derrildsouza/Advanced-IoT-Home-Automation-System/docs/images/board_cliparts_showcase.jpg

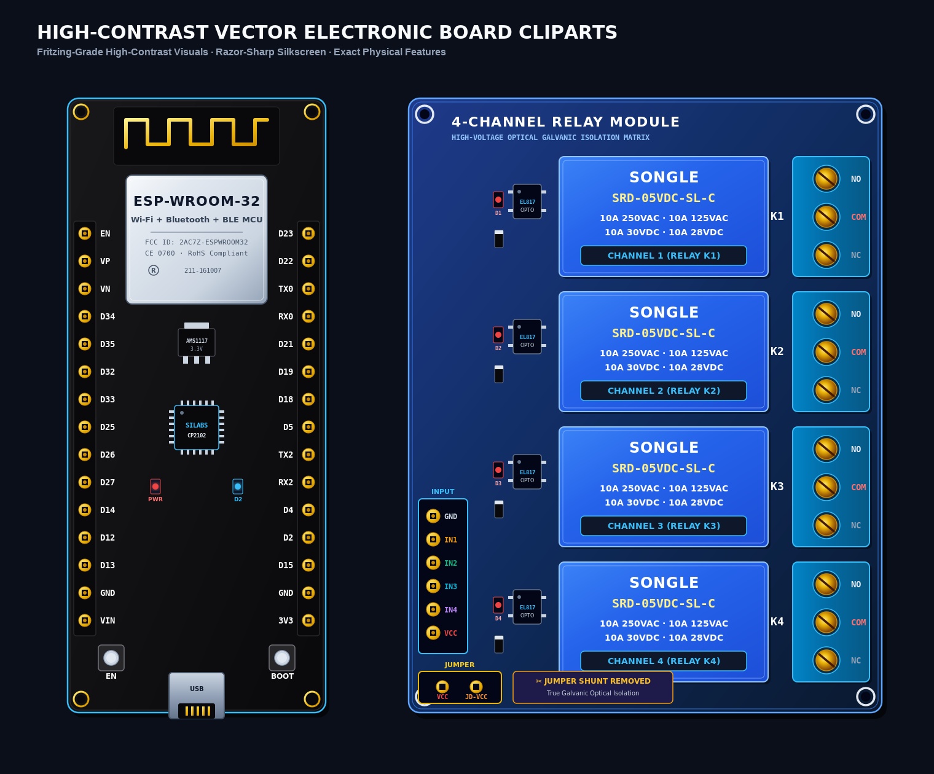
docs/images/board_cliparts_showcase.jpg
