derrildsouza/Advanced-IoT-Home-Automation-System/docs/images/esp32_board_clipart.png

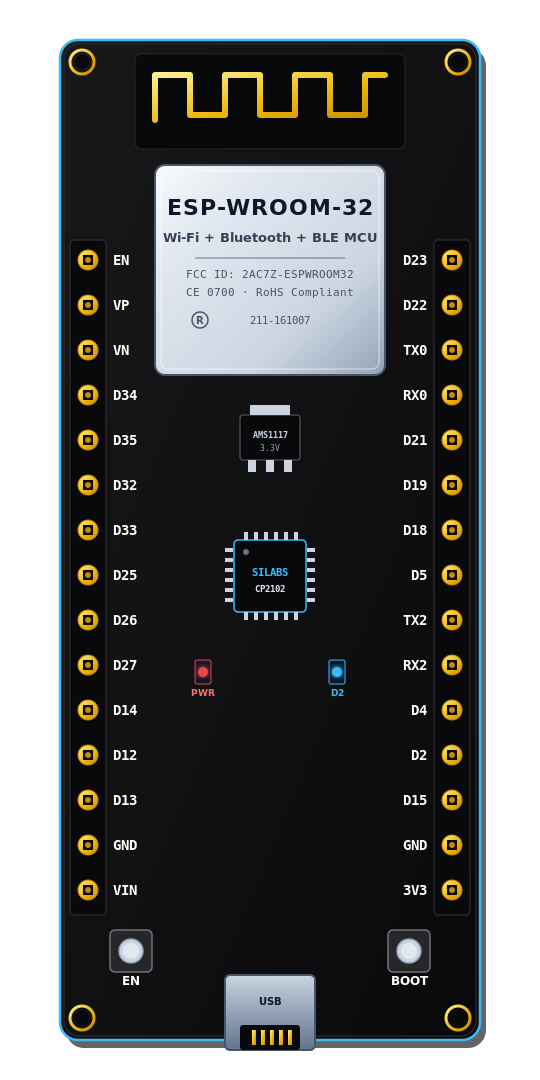
docs/images/esp32_board_clipart.png
