derrildsouza/Advanced-IoT-Home-Automation-System/docs/images/esp32_board_photo.png

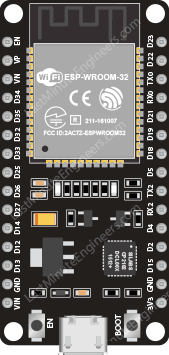
docs/images/esp32_board_photo.png
