derrildsouza/Advanced-IoT-Home-Automation-System/docs/images/hlk_ams1117_schematic.jpg

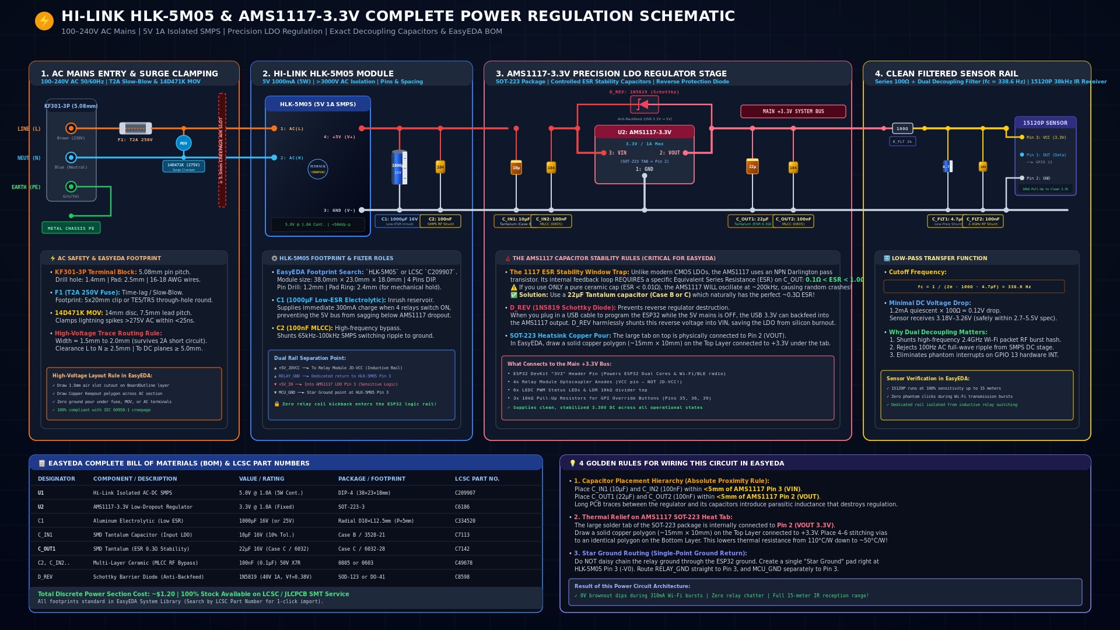
docs/images/hlk_ams1117_schematic.jpg
