derrildsouza/Advanced-IoT-Home-Automation-System/docs/images/minimal_power_schematic.jpg

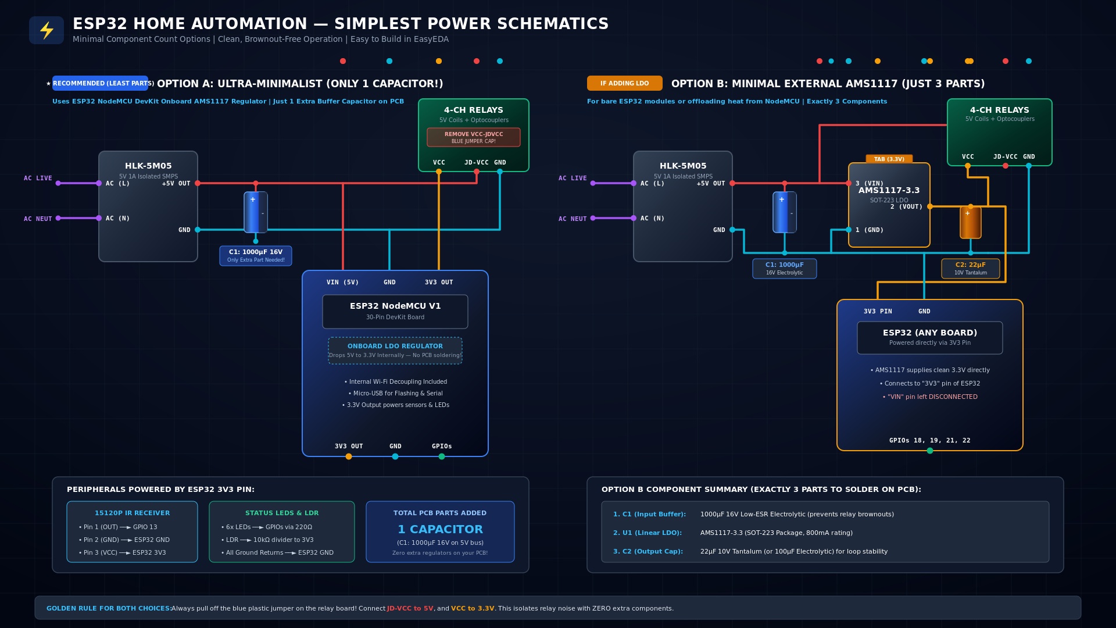
docs/images/minimal_power_schematic.jpg
