derrildsouza/Advanced-IoT-Home-Automation-System/docs/images/relay_module_clipart.png

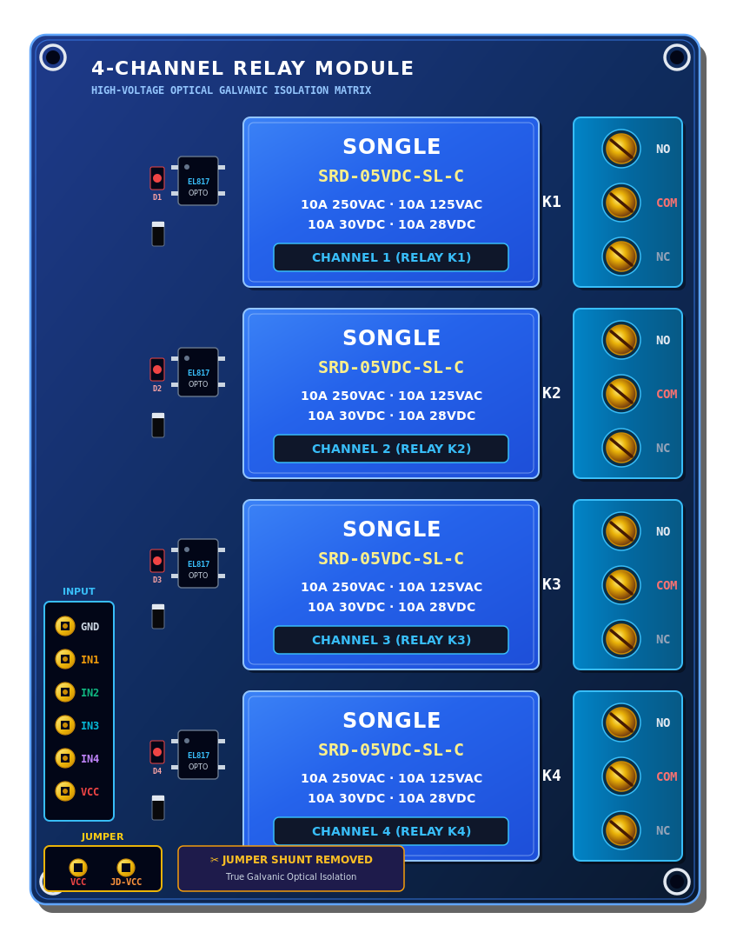
docs/images/relay_module_clipart.png
