derrildsouza/Advanced-IoT-Home-Automation-System/docs/images/relay_module_photo.png

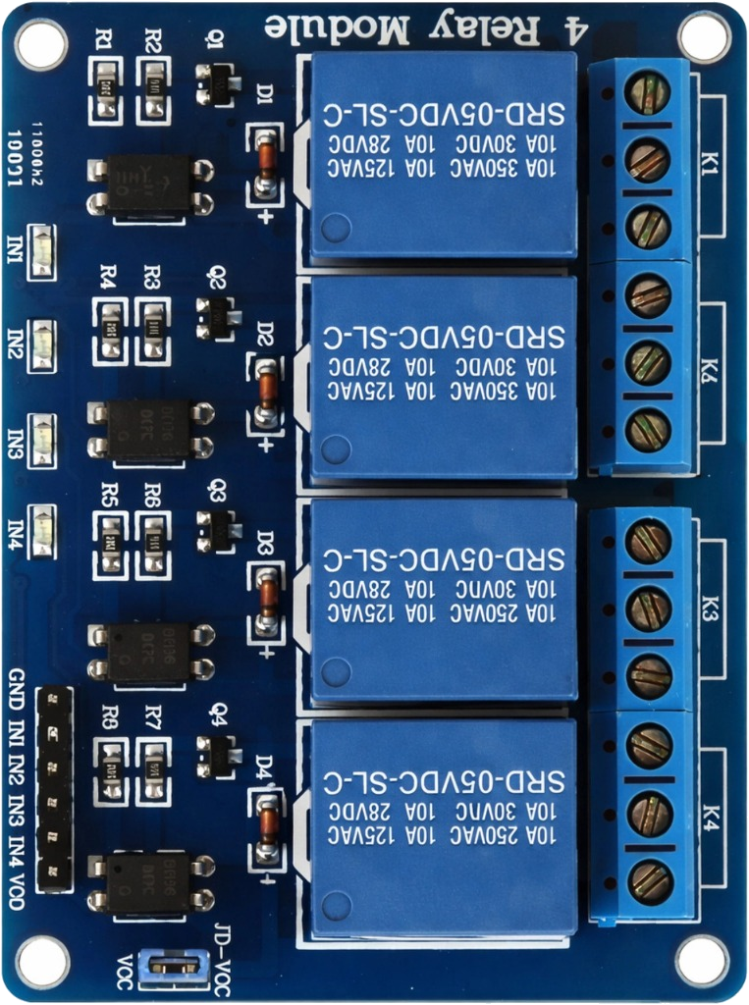
docs/images/relay_module_photo.png
