derrildsouza/Advanced-IoT-Home-Automation-System/docs/images/sensors_and_io_schematic.jpg

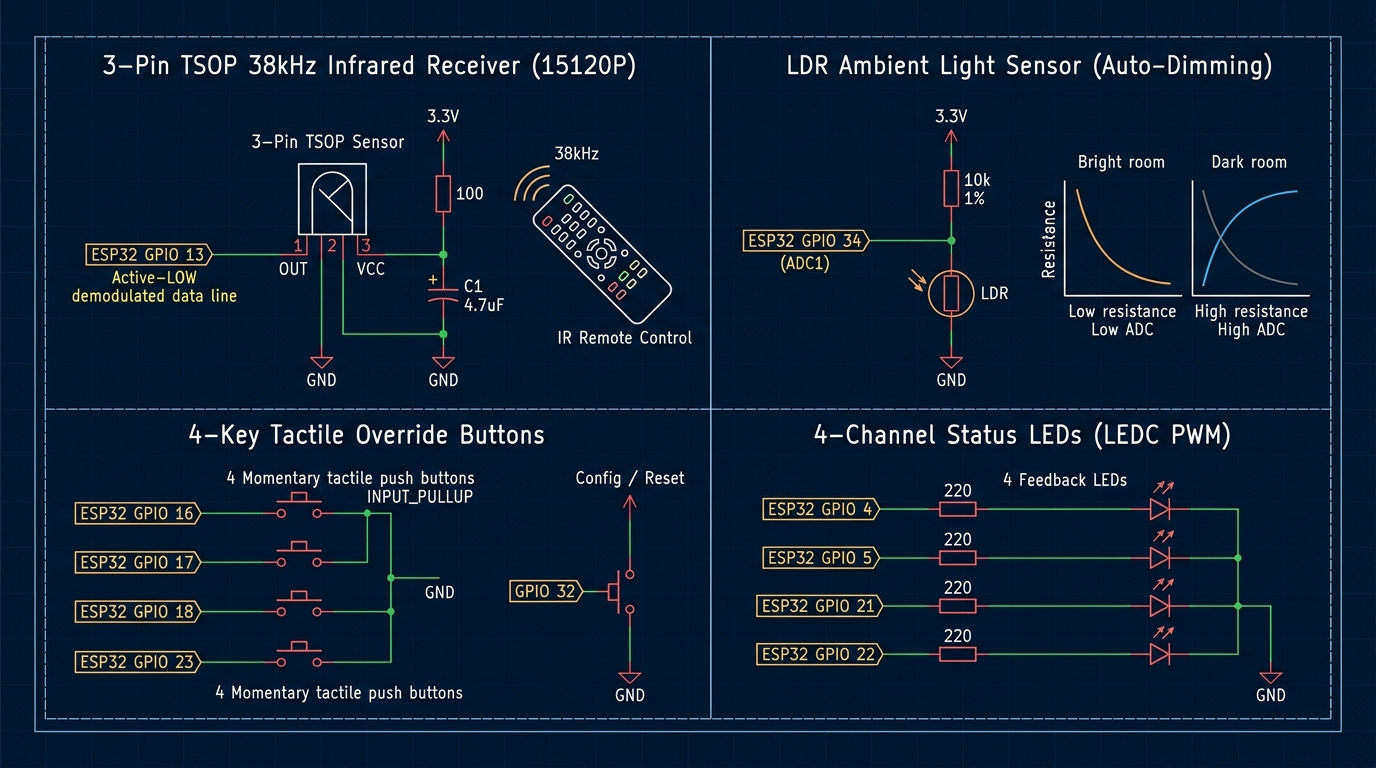
docs/images/sensors_and_io_schematic.jpg
