derrildsouza/Advanced-IoT-Home-Automation-System/(commit log)

2026-09-20 added wiring diagrams within docs
2026-09-20 updated circuit schematics
2026-09-20 updated ir and LDR schematics
2026-09-24 update default host to 192.168.1.20 and allow switch status --json
2026-09-24 add Section 3.5 6-Channel Status & Diagnostic LEDs schematic diagram
2026-09-27 modifiied IR circuitry
2026-09-27 renamed TSOP IR led
2026-09-27 Added power distribution circuit
2026-10-04 added power diagrams
2026-10-04 circuit updation
2026-10-04 circuit gpio updation
2026-10-05 PCB plan
